t8toel00/ProgrammablePSU/Presentation docs/layout_capture_02.jpg

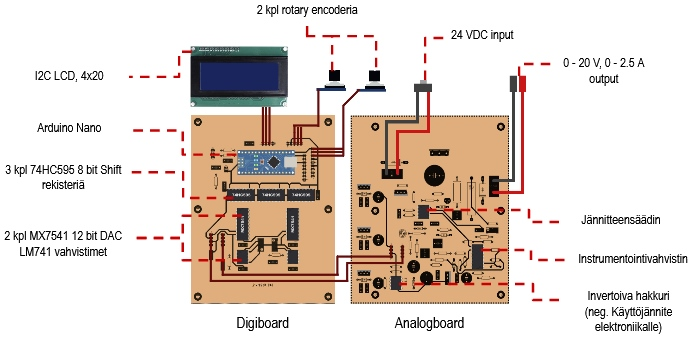
Presentation docs/layout_capture_02.jpg
