t8toel00/ProgrammablePSU/Presentation docs/tuotekuva.jpg

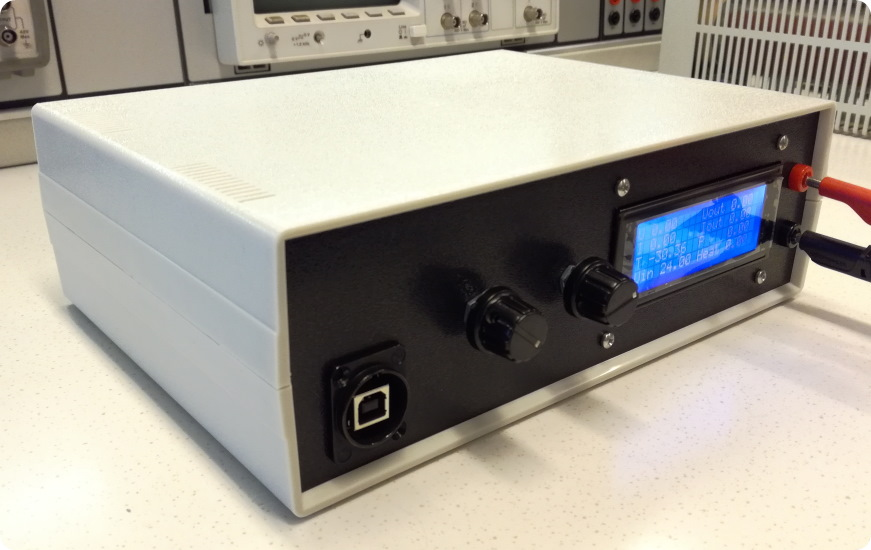
Presentation docs/tuotekuva.jpg
