t8toel00/ProgrammablePSU/Presentation docs/ui.jpg

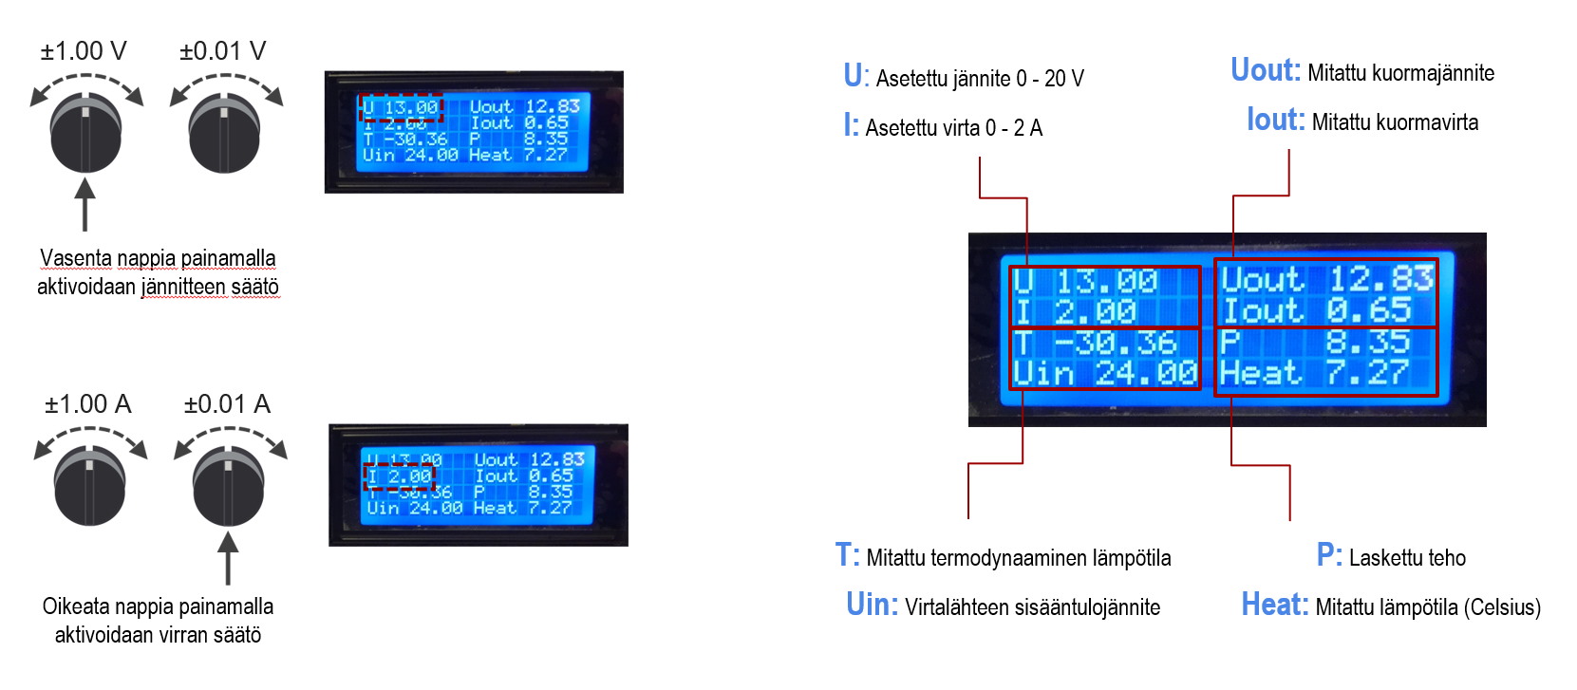
Presentation docs/ui.jpg
