t8toel00/ProgrammablePSU/Eagle files/boardv2_copy3.brd

## EAGLE design Eagle files/boardv2_copy3.brd (2019-12-24)

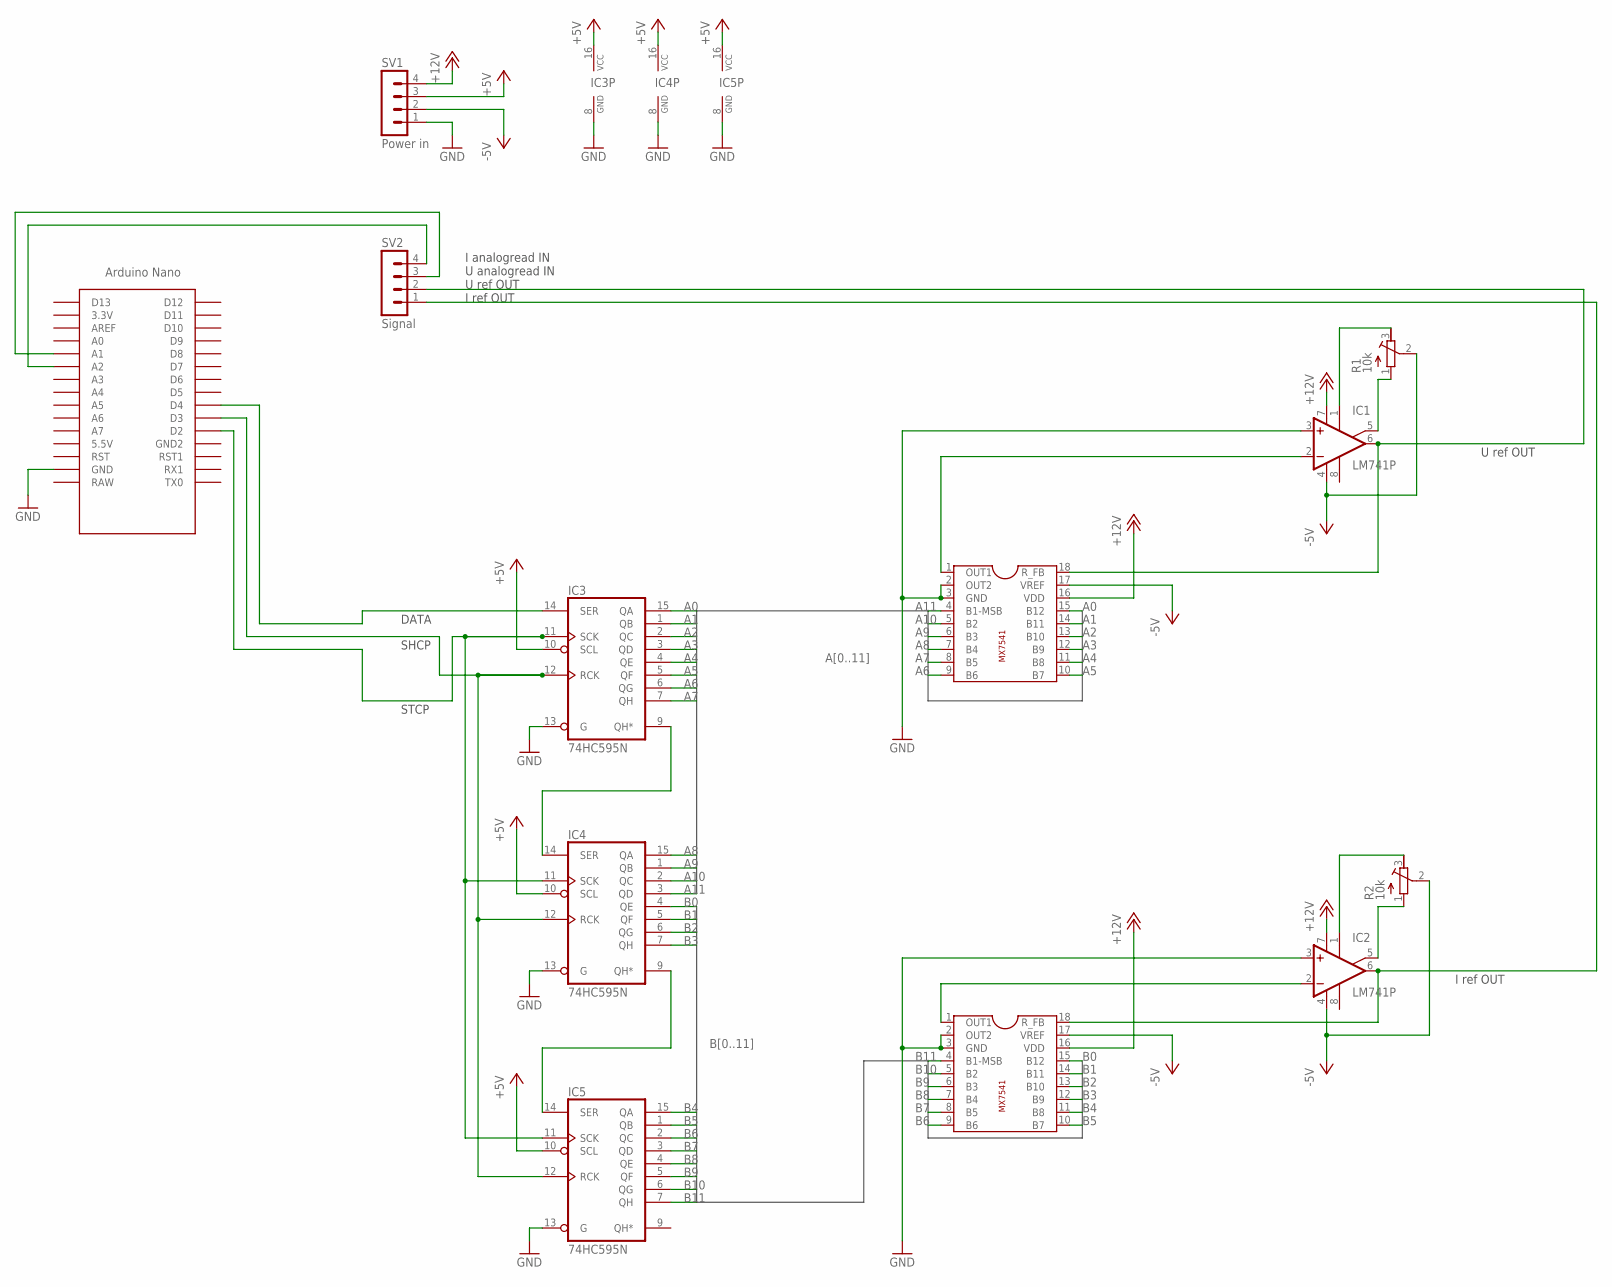
[picture p9: schematic boardv2_copy3.sch]

Parts:
IC1, IC2: LM741P; DIL08
IC3, IC4, IC5: 74HC595N; DIL16
R1, R2: 10k; RTRIM64W
SV1: Power in; MA04-1
SV2: Signal; MA04-1
U$1, U$2: MX7541
U$3: NANO

Connections:
+5V: IC3.10 (SCL), IC3.16 (VCC), IC4.10 (SCL), IC4.16 (VCC), IC5.10 (SCL), IC5.16 (VCC), SV1.3
+12V: IC1.7 (V+), IC2.7 (V+), SV1.4, U$1.16 (VDD), U$2.16 (VDD)
-5V: IC1.4 (V-), IC2.4 (V-), R1.2 (S), R2.2 (S), SV1.2, U$1.17 (VREF), U$2.17 (VREF)
A0: IC3.15 (QA), U$1.15 (B12)
A1: IC3.1 (QB), U$1.14 (B11)
A2: IC3.2 (QC), U$1.13 (B10)
A3: IC3.3 (QD), U$1.12 (B9)
A4: IC3.4 (QE), U$1.11 (B8)
A5: IC3.5 (QF), U$1.10 (B7)
A6: IC3.6 (QG), U$1.9 (B6)
A7: IC3.7 (QH), U$1.8 (B5)
A8: IC4.15 (QA), U$1.7 (B4)
A9: IC4.1 (QB), U$1.6 (B3)
A10: IC4.2 (QC), U$1.5 (B2)
A11: IC4.3 (QD), U$1.4 (B1-MSB)
B0: IC4.4 (QE), U$2.15 (B12)
B1: IC4.5 (QF), U$2.14 (B11)
B2: IC4.6 (QG), U$2.13 (B10)
B3: IC4.7 (QH), U$2.12 (B9)
B4: IC5.15 (QA), U$2.11 (B8)
B5: IC5.1 (QB), U$2.10 (B7)
B6: IC5.2 (QC), U$2.9 (B6)
B7: IC5.3 (QD), U$2.8 (B5)
B8: IC5.4 (QE), U$2.7 (B4)
B9: IC5.5 (QF), U$2.6 (B3)
B10: IC5.6 (QG), U$2.5 (B2)
B11: IC5.7 (QH), U$2.4 (B1-MSB)
GND: IC1.3 (+IN), IC2.3 (+IN), IC3.8 (GND), IC3.13 (G), IC4.8 (GND), IC4.13 (G), IC5.8 (GND), IC5.13 (G), SV1.1, U$1.2 (OUT2), U$1.3 (GND), U$2.2 (OUT2), U$2.3 (GND), U$3.GND
unnamed: IC3.9 (QH*), IC4.14 (SER)
unnamed: IC4.9 (QH*), IC5.14 (SER)
unnamed: IC3.11 (SCK), IC4.11 (SCK), IC5.11 (SCK), U$3.D2
unnamed: IC3.12 (RCK), IC4.12 (RCK), IC5.12 (RCK), U$3.D3
unnamed: IC3.14 (SER), U$3.D4
unnamed: SV2.4, U$3.A2
unnamed: SV2.3, U$3.A1
unnamed: IC1.2 (-IN), U$1.1 (OUT1)
unnamed: IC2.2 (-IN), U$2.1 (OUT1)
unnamed: IC1.1 (ON1), R1.3 (E)
unnamed: IC1.5 (ON2), R1.1 (A)
unnamed: IC2.1 (ON1), R2.3 (E)
unnamed: IC2.5 (ON2), R2.1 (A)
unnamed: IC1.6 (OUT), SV2.2, U$1.18 (R_FB)
unnamed: IC2.6 (OUT), SV2.1, U$2.18 (R_FB)

Notes on the sheet:
SHCP
STCP
DATA
U ref OUT
I ref OUT
I analogread IN U analogread IN U ref OUT I ref OUT

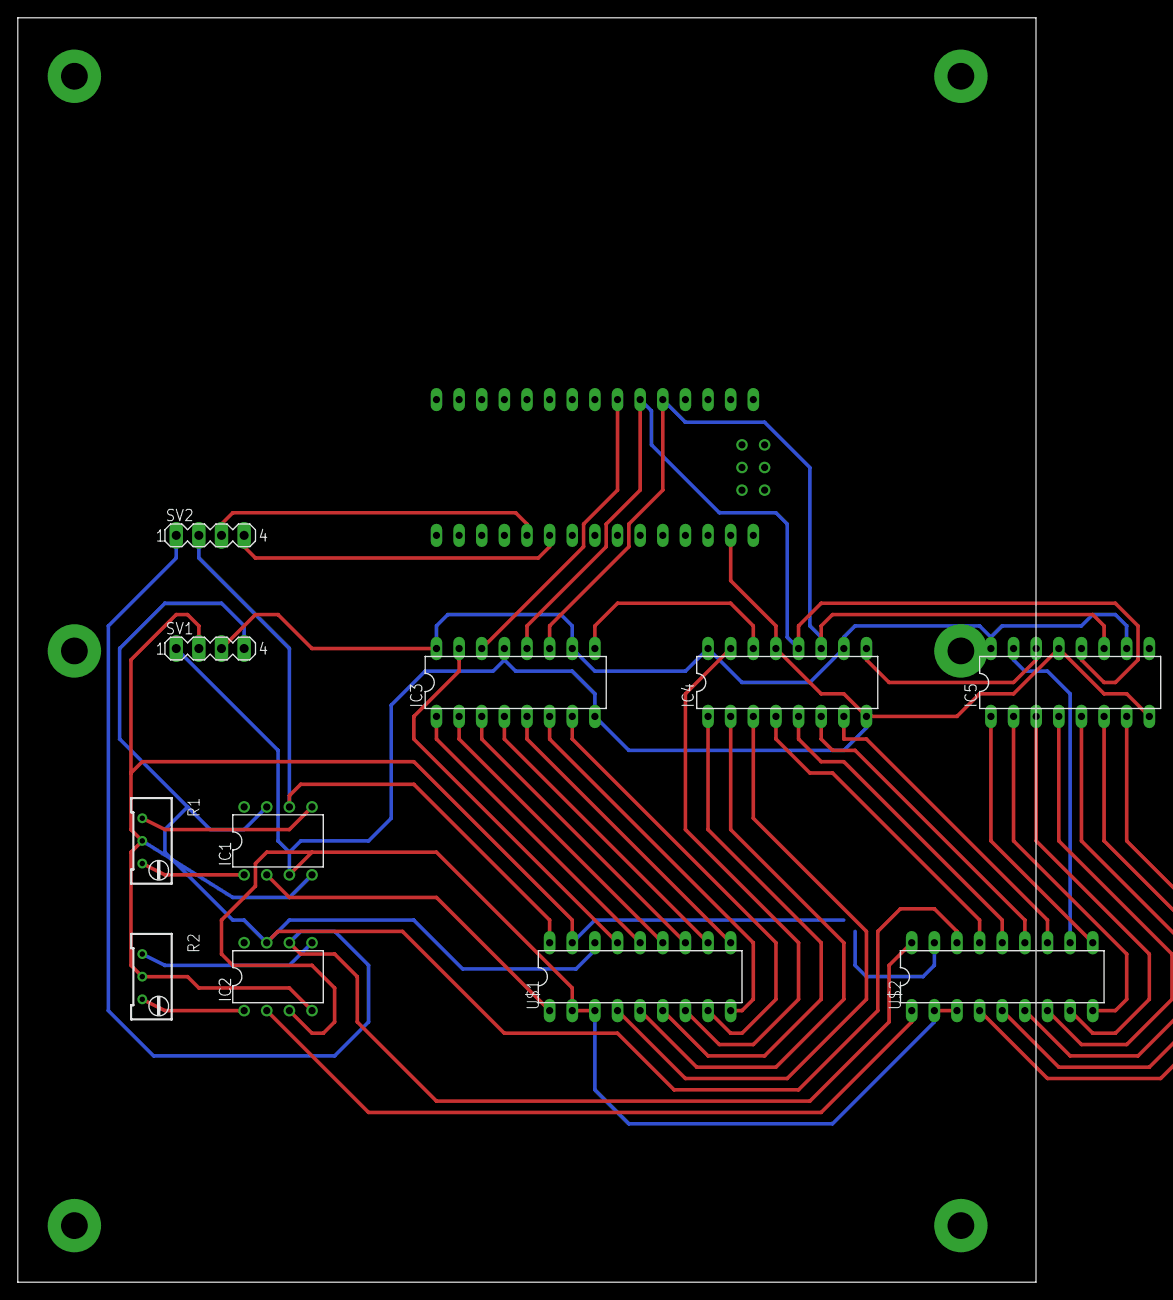
[picture p10: board boardv2_copy3.brd from above]

Board: 2 copper layers, 114.3 x 141.9 mm, 12 parts (0 on the bottom side), 43 nets.
